joshua6503/IoT_Project_V2V_Motorsport_Telemetry/firmware/rw612-node/app/README.md

# app/

Top layer: `main.c`, RTOS task creation, node state machine, wiring of services.
No SDK includes, no register access. Calls `services/` and `firmware/common/`.
