joshua6503/IoT_Project_V2V_Motorsport_Telemetry/firmware/rw612-node/board/README.md

# board/

The only layer allowed to include the NXP SDK (`fsl_*.h`): pin mux, clocks,
board init, thin wrappers over SDK peripherals (GPIO, I2C, timers).
Pin assignments must match `hardware/pinout.md`.
