joshua6503/IoT_Project_V2V_Motorsport_Telemetry/firmware/rw612-node/drivers/README.md

# drivers/

Device drivers for external parts (IMU, distance sensor, temperature sensor,
buzzer, haptic, relay). Each driver exposes a small hardware-agnostic API and
talks to the MCU only through `board/`. Part models are TBD (`hardware/bom.md`).
