joshua6503/IoT_Project_V2V_Motorsport_Telemetry/docs/project-notes.md

# Project notes (decision log)

Short, dated entries. Anything that becomes a lasting decision gets an ADR.

## 2026-11-10

- HANDOFF-006: bench capture `capture3` (FW `ec329fe`, FIR on, CSV on) stored as evidence in
  `docs/04-testing/evidence/pds-2026-11-10/`; HIL-19 passed. DEC-010 confirmed on the bench:
  576 / 600 intervals exactly 50 ms, 12 pairs of 74 / 26 ms (one per DHT11 read), 20.000 Hz,
  fs/2 image gone. DEC-009 parameters (fs 20 Hz, N 9, fc 2 Hz, Hamming) validated, no longer
  ASSUMPTION: useful brake content < ~1.5 Hz; 20–30 dB attenuation above ~3.5 Hz, below −80 dB
  above 5.5 Hz; 2.5 Hz tapping attenuated only ~5 dB (transition band of 9 taps). Trade-off:
  21 taps (500 ms group delay) would be more selective, but low delay on HARD_BRAKE is
  prioritised over selectivity. `APP_LOG_DSP_CSV` back to 0 (normal debug log).
- Bench: the 100 % → 0 % spikes in the first DSP capture were a loose contact (wires and pot
  now fixed in place). No code issue.
- Bench capture 2 (`tools/dsp/out/capture2.csv`, not committed): the brake sample interval
  alternated 62 / 38 ms (mean 50.0 ms). Cause: the blocking HC-SR04 read ran before the pot slot
  and `t_sensor = now` carried its delay forward. The periodic non-uniform sampling put a
  spurious image near fs/2 (≈ 9.6 Hz) in the raw FFT.
- HANDOFF-005 applied:
  - DEC-010: pot slot runs before the HC-SR04 and keeps a fixed 50 ms grid
    (`t_sensor += period`, resync if more than one period late). Host model of the loop: the
    old order reproduces the bench 62 / 38 ms exactly (12 ms echo); with DEC-010 the interval
    is 50 ms outside DHT11 reads (std 0.0–1.0 ms for echo blocks of 5–30 ms; ≈ 5.1 ms with ECHO in
    fault, 35 ms block, because the HC-SR04 phase moves after each DHT11 read), 74 / 26 ms around
    each DHT11 read. With `APP_ENABLE_BRAKE_FIR 0` the only change from the previous firmware is
    DEC-010 plus the brake calibration.
  - DEC-011: divider values as wired (ECHO 2 kΩ / 2.7 kΩ ≈ 2.9 V; brake 5.1 kΩ / 2 kΩ pot /
    220 Ω, 0.10–1.00 V; TPS 2.7 kΩ / 1 kΩ pot / 220 Ω, 0.19–1.03 V; calculated). Brake pot
    calibrated on the bench: raw 2850 / 29320.
  - CONFLICT-003 resolved, option A: filtered brake keeps feeding `alert_evaluate()`;
    HIL-18 uses fast presses to ≥ 90 %; thresholds stay ASSUMPTION (OPEN-005).
    On the bench Joshua reports that HARD_BRAKE does trigger on fast presses with the filter
    on (informal check, not HIL-18 evidence).

## 2026-11-09

- HANDOFF-004 (PDS brake-pressure FIR on top of MP1) applied:
  - REQ-F-015 (FIR as discrete convolution in `firmware/common/`) and REQ-F-016 (UART export
    + host FFT) added.
  - DEC-009: `APP_ENABLE_BRAKE_FIR` (default 1) feeds the filtered brake to `alert_evaluate()`;
    0 = MP1 unchanged (preprocessed translation unit identical to the MP1 commit).
    fs = 20 Hz, N = 9, fc = 2 Hz, Hamming — ASSUMPTION, to validate with a raw capture.
    Group delay 200 ms, logged at boot.
  - `fir_filter.c` + `test_fir_filter.c` (golden test vs `numpy.convolve`); coefficients and
    reference generated by `tools/dsp/design_fir.py`; `tools/dsp/analyze_capture.py` for the
    spectra; `APP_LOG_DSP_CSV` for a clean `dsp,` capture.
  - New: OPEN-016 (faster, timer-triggered ADC sampling). CONFLICT-003 reported: with the
    filter on, fast presses peaking at 75–80 % may no longer meet the HARD_BRAKE rate rule
    (host simulation); HIL-18/HIL-20 will measure it.

## 2026-10-14

- HANDOFF-002 + HANDOFF-003 (MP1 pin map and review fixes) applied:
  - DEC-005 MP1 pin map (D3–D9, Pmod J7-3) in `board_pins.h` and `hardware/pinout.md`;
    OPEN-003 resolved for MP1.
  - DEC-006 HC-SR04 every 100 ms, DHT11 every 2500 ms (datasheet limits enforced at build time).
  - DEC-007 timebase on CTIMER1; CTIMER0 kept for the passive-buzzer PWM on GPIO_0.
  - DEC-008 HC-SR04 out of range = valid 500 cm reading, no echo start = fault;
    `sensor_fault` from the `sensor_ok` bits only.
  - New: OPEN-014 (ADC channel of A0, boot scan), OPEN-015 (5 V tolerance, ECHO divider).
  - Log line gains `brake_raw=` to calibrate `APP_POT_BRAKE_RAW_MIN/MAX` on the bench.

- HANDOFF-001 (MP1 perception node) applied. Approved in chat today:
  - CONFLICT-001 resolved: V2V = BLE; ADR-0001 → Accepted; Thread/802.15.4 stays M4.
  - CONFLICT-002 resolved: MP1 = local part of M3; V2V moves to MP2.
  - REQ-F-014 added (local decide + actuate, no network); REQ-F-009 note: IMU replaced by
    the brake-pressure potentiometer for MP1.
  - DEC-001 `hello_world` base, bare-metal superloop (FreeRTOS deferred to MP2).
  - DEC-002 MP1 scope: HC-SR04, DHT11, 2 potentiometers (brake, TPS), LEDs, buzzer, UART log.
  - DEC-003 arbitration: highest severity, tie-break HARD_BRAKE > OBSTACLE > OVERTEMP.
  - DEC-004 actuator patterns; closes OPEN-006 for MP1.
- New open items: OPEN-012 (`brake_pct`/`tps_pct` in the JSON schema before MP2),
  OPEN-013 (buzzer active vs passive, bench test). OPEN-005 stays open; bench defaults
  in `alert_config_default()`.
- Code: stateful `alert_evaluate()` + `alert_pattern` in `firmware/common` with unit tests;
  RW612 layers `app/services/drivers/board` for MP1; pins pending HANDOFF-002.

## 2026-09-30

- Repository scaffold created (structure, contracts, CI, docs). No firmware logic yet.
- ADR-0001..0005 accepted: BLE for V2V, ESP32/Arduino as node B, local
  Mosquitto, contracts-first monorepo, layered firmware.
- Protocol v0.1: 16-byte `v2v_packet_t`, GATT service UUID base `2b7b0001-fbc4-4f74-84ba-26504f32ca72`.
- Locally installed MCUXpresso SDK for FRDM-RW612 reports version 26.06.00 in its
  manifest; team-wide SDK version → OPEN-001.
- To validate: BLE/802.15.4 simultaneity on the RW612 → OPEN-011 (ASSUMPTION).
- Pending, tracked in [`STATUS.md`](STATUS.md): pin assignment → OPEN-003;
  sensor/actuator and ESP32 dev-kit models → OPEN-004; alert thresholds → OPEN-005;
  time base → OPEN-007.
- Workflow adopted: chat = architect, Claude Code = implementer, rw612-tutor = technical
  advisor; L0–L3 and ADR-0001..0005 moved back to Proposed pending team review.
