joshua6503/IoT_Project_V2V_Motorsport_Telemetry/docs/deliverables/README.md

# Entregables escolares

Índice de los entregables de la materia de IoT. Los documentos técnicos del
proyecto están en inglés en `docs/`; aquí van las versiones en español que se
entregan al profesor.

| # | Entregable | Archivo | Fecha de entrega | Estado |
|---|---|---|---|---|
| 1 | Propuesta del proyecto | TBD | TBD | pendiente |
| 2 | Arquitectura en 4 capas (Percepción/Actuación → Comunicación → Procesamiento → Aplicación) | TBD | TBD | pendiente |
| 3 | Avance M1: V2V por BLE (botón → LED/buzzer) | TBD | TBD | pendiente |
| 4 | Avance M2: telemetría MQTT + dashboard | TBD | TBD | pendiente |
| 5 | Avance M3: sensores y actuadores reales | TBD | TBD | pendiente |
| 6 | Reporte final y presentación | TBD | TBD | pendiente |

## Fuentes para redactar

- Visión y problema: [`../00-vision/vision.md`](../00-vision/vision.md)
- Requisitos: [`../01-requirements/requirements.md`](../01-requirements/requirements.md)
- Arquitectura y diagramas (4 capas): [`../02-architecture/architecture.md`](../02-architecture/architecture.md)
- Decisiones justificadas: [`../adr/`](../adr/)
- Plan de pruebas: [`../04-testing/test-plan.md`](../04-testing/test-plan.md)

## Equipo

- Joshua Alejandro Chávez Montero
- Mario Alberto Mireles González
- Kevin Rincones Partida
- Jair Santana Renteria
