joshua6503/IoT_Project_V2V_Motorsport_Telemetry/docs/04-testing/test-plan.md

# Test plan

## Levels

| Level | What | Tooling | Where | Runs in CI |
|---|---|---|---|---|
| Unit | pure logic in `firmware/common/`, C contract layout | Unity + host gcc | `tests/unit/` | yes |
| Integration | simulator → Mosquitto → subscriber, JSON Schema validation | pytest, paho-mqtt, jsonschema | `tests/integration/` | schema tests yes; broker tests skip without a broker |
| HIL | real boards, BLE link, actuators, timing | checklist + logic analyser/phone scanner | `tests/hil/hil-checklist.md` | no |

## Entry/exit per milestone

- **M1 exit:** HIL-01..HIL-05 pass; latency measured and recorded (even if above target).
- **M2 exit:** integration tests pass against the real broker; HIL-06..HIL-09 pass.
- **M3 exit:** unit tests cover every rule in `alert_evaluate()`; HIL-10..HIL-12 pass.
- **MP1 exit (local part of M3):** `make -C tests/unit` passes; HIL-16..HIL-18 pass on the RW612.

## Traceability

| Requirement | Test(s) | Level | Status |
|---|---|---|---|
| REQ-F-001 | HIL-01 | HIL | not run |
| REQ-F-002 | HIL-02 | HIL | not run |
| REQ-F-003 | UT (packet decode, TBD) · HIL-03 | unit/HIL | not written |
| REQ-F-004 | `test_simulated_telemetry_matches_schema` · `test_simulator_telemetry_reaches_broker_and_is_valid` · HIL-06 | int/HIL | sim: passing |
| REQ-F-005 | IT status/LWT (TBD) · HIL-07 | int/HIL | not written |
| REQ-F-006 | `test_simulated_alert_matches_schema` · HIL-08 | int/HIL | sim: passing |
| REQ-F-007 | HIL-09 (manual, dashboard) | HIL | not run |
| REQ-F-008 | `test_payloads.py` · `test_broker_roundtrip.py` | int | passing / skipped w/o broker |
| REQ-F-009 | HIL-10 | HIL | not run |
| REQ-F-010 | `test_alert_evaluate_*`, `test_obstacle_*`, `test_overtemp_*`, `test_hard_brake_*`, `test_arbitration_*` (DEC-003) · HIL-11 · HIL-16..18 | unit/HIL | unit: passing (bench thresholds, OPEN-005) |
| REQ-F-011 | `test_pattern_*` (DEC-004) · `test_shift_level_*` · HIL-12 | unit/HIL | unit: passing |
| REQ-NF-001 | HIL-04 (latency) | HIL | not run |
| REQ-NF-002 | HIL-06 (rate from broker timestamps) | HIL | not run |
| REQ-NF-003 | HIL-13 (pull AP / stop broker) | HIL | not run |
| REQ-NF-004 | HIL-04 + HIL-06 with both radios active | HIL | not run |
| REQ-NF-005 | HIL-05 (gateway off) | HIL | not run |
| REQ-NF-006 | HIL-14 (BLE reconnect) | HIL | not run |
| REQ-NF-007 | CI job `unit-tests` | unit | passing |
| REQ-NF-008 | `test_protocol_*` · CI `sync_protocol` diff check | unit/CI | passing |
| REQ-NF-009 | `.gitignore` + PR checklist | review | — |
| REQ-NF-010 | HIL-15 | HIL | not run |
| REQ-F-014 | `test_alert_*`, `test_pattern_*` (logic) · HIL-16 obstacle demo · HIL-17 overtemp demo · HIL-18 hard-brake demo | unit/HIL | unit: passing · HIL: not run |
| REQ-F-015 | `test_fir_*` in `tests/unit/test_fir_filter.c` (init, impulse, step, ready/reset, golden vs `numpy.convolve`) · HIL-19 · HIL-20 | unit/HIL | unit: passing · HIL-19: passed 2026-11-10 · HIL-20: not run |
| REQ-F-016 | `analyze_capture.py` on `tools/dsp/samples/synthetic_capture.txt` (manual) · HIL-19 | tool/HIL | tool: works on synthetic data · HIL-19: passed 2026-11-10 |

## MP1 HIL demos (RW612, no network)

| ID | Procedure | Expected | Status |
|---|---|---|---|
| HIL-16 | Obstacle demo: move a hand towards the HC-SR04 from > 30 cm to < 15 cm, aim it at open space, then unplug ECHO. | NONE → OBSTACLE WARNING (yellow, 1 Hz beep) → CRITICAL (red 4 Hz + beep); open space → `dist=500.0`, NONE, `fault=0` (DEC-008); ECHO unplugged → `dist=-1.0`, `fault=1`, red/yellow alternating when no other alert. | not run |
| HIL-17 | Overtemp demo: warm the DHT11 (fingers/hair dryer) above 30 °C, then above 35 °C, then let it cool. | OVERTEMP WARNING at ≥ 30 °C, CRITICAL at ≥ 35 °C, stays WARNING until ≤ 28 °C (hysteresis). | not run |
| HIL-18 | Hard-brake demo: turn potentiometer #1 0 → **≥ 90 %** fast (< 0.4 s), release; repeat slowly (> 1 s). Run with the default `APP_ENABLE_BRAKE_FIR 1` (CONFLICT-003, option A). | Fast: HARD_BRAKE CRITICAL latched ~2 s. Slow: no HARD_BRAKE. Fast presses peaking at only 75–80 % may not trigger with the filter on; that is expected and not a failure (CONFLICT-003, thresholds ASSUMPTION under OPEN-005). | not run |

## PDS HIL (brake FIR, DEC-009)

| ID | Procedure | Expected | Status |
|---|---|---|---|
| HIL-19 | Spectrum: build with `APP_LOG_DSP_CSV 1`, run `python tools\dsp\analyze_capture.py --port COMx --seconds 30` while moving the brake pot (slow presses + fast wiggles). Record the boot `fir` line. | Real fs ≈ 20 Hz with jitter reported (DHT11 slot skips, DEC-006); sample-interval std **< 5 ms** outside DHT11 reads (DEC-010 fixed grid, no 62/38 ms alternation; target, to validate); FFT of y[n] attenuated above fc = 2 Hz compared to x[n] (stop band ≈ −40 dB or lower for the N = 9 Hamming design); y lags x by ≈ 200 ms in the time plot. Keep the PNGs/CSV for the report. | **passed 2026-11-10** (`capture3`, FW `ec329fe`): 576 / 600 intervals exactly 50 ms, 12 pairs of 74 / 26 ms (DHT11 reads), 20.000 Hz, no fs/2 image; useful content < ~1.5 Hz; 20–30 dB attenuation above ~3.5 Hz, below −80 dB above 5.5 Hz; 2.5 Hz tapping only ~5 dB (transition band, accepted, DEC-009); y lags x by 200 ms. Evidence: [`evidence/pds-2026-11-10/`](evidence/pds-2026-11-10/) |
| HIL-20 | False / missed HARD_BRAKE: with `APP_LOG_DSP_CSV 0`, do the same sequence (10 slow presses to 60 %, 10 wiggles around 60 %, 10 fast presses to ~80 % and 10 to ~100 %) once with `APP_ENABLE_BRAKE_FIR 0` and once with `1`; count HARD_BRAKE events in the log. | Filter on: fewer or equal false HARD_BRAKE on slow presses/wiggles; fast presses to ~100 % still trigger. Record the count of fast ~80 % presses that no longer trigger (CONFLICT-003). | not run |

## How to run

```powershell
make -C tests/unit
pip install -r tests/integration/requirements.txt
pytest tests/integration -v
```
