joshua6503/IoT_Project_V2V_Motorsport_Telemetry/docs/04-testing/evidence/pds-2026-11-10/capture3.csv

t_ms | x_pct | y_pct
17476 | 0.1 | 0.1
17526 | 0.1 | 0.1
17576 | 0.1 | 0.1
17626 | 0.1 | 0.1
17676 | 0.1 | 0.1
17726 | 0.1 | 0.1
17776 | 0.1 | 0.1
17826 | 0.1 | 0.1
17876 | 0.1 | 0.1
17926 | 0.1 | 0.1
17976 | 0.1 | 0.1
18026 | 0.1 | 0.1
18076 | 0.1 | 0.1
18126 | 0.1 | 0.1
18176 | 0.1 | 0.1
18226 | 0.1 | 0.1
18276 | 0 | 0.1
18326 | 0 | 0.1
18376 | 0 | 0.1
18426 | 0.1 | 0.1
18476 | 0.1 | 0.1
18526 | 0 | 0.1
18576 | 0.1 | 0.1
18626 | 0.1 | 0.1
18676 | 0.1 | 0.1
18726 | 0.1 | 0.1
18776 | 0.1 | 0.1
18826 | 0.1 | 0.1
18876 | 0.1 | 0.1
18926 | 0.1 | 0.1
18976 | 0.1 | 0.1
19026 | 0.1 | 0.1
19076 | 0.1 | 0.1
19126 | 0.1 | 0.1
19176 | 0.1 | 0.1
19226 | 0.1 | 0.1
19276 | 0.3 | 0.1
19326 | 4.5 | 0.1
19376 | 9.4 | 0.3
19426 | 14 | 1
19476 | 18.2 | 2.7
19526 | 22.1 | 5.6
19600 | 27.6 | 9.5
19626 | 29.4 | 13.8
19676 | 33.1 | 18.1
19726 | 37.3 | 22.3
19776 | 41.6 | 26.2
19826 | 46.3 | 29.9
19876 | 50.7 | 33.6
19926 | 54.4 | 37.6
19976 | 57.7 | 41.8
20026 | 60.7 | 46.1
20076 | 63.4 | 50.2
20126 | 66.1 | 54
20176 | 68.6 | 57.4
20226 | 70.6 | 60.4
20276 | 71.1 | 63.2
20326 | 71.1 | 65.8
20376 | 71.1 | 68
20426 | 71.1 | 69.6
20476 | 71.1 | 70.5
20526 | 71.1 | 71
20576 | 71.1 | 71.1
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
