joshua6503/IoT_Project_V2V_Motorsport_Telemetry/docs/04-testing/evidence/pds-2026-11-10/capture3_time.png

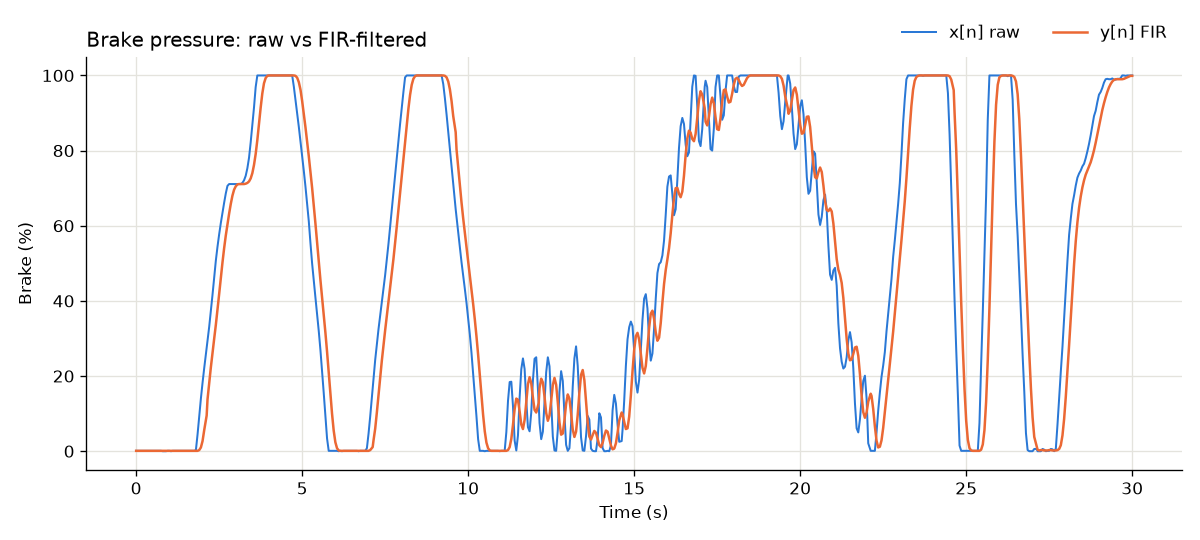
docs/04-testing/evidence/pds-2026-11-10/capture3_time.png
