joshua6503/IoT_Project_V2V_Motorsport_Telemetry/(commit log)

2026-10-15 docs(hardware): MP1 decisions and pin map (CONFLICT-001/002, REQ-F-014, DEC-001..008, OPEN-012..015)
2026-10-15 feat(rw612): MP1 perception node, pin map and verified IDE integration steps (REQ-F-014, DEC-005..008)
2026-11-10 feat(common): FIR filter as discrete convolution with golden unit tests (REQ-F-015, DEC-009)
2026-11-10 feat(rw612): brake FIR and DSP CSV capture behind build switches (REQ-F-015, REQ-F-016, DEC-009)
2026-11-10 fix(rw612): drift-free brake pot slot before HC-SR04, bench brake calibration (DEC-010, DEC-011)
    [app_config.h, main_mp1.c]
2026-11-10 docs(hardware): MP1 divider and pot values as wired (DEC-011)
2026-11-10 docs(test): PDS bench evidence and FIR validation (DEC-009)
    [capture3.csv]
